rauhul/ece395/flywheel_gearbox/flywheel_gearbox_parts.docx

Note: The Vex Robotics site has multiple parts per page.

Part | Part No. | Unit Price | Quantity | Total Cost | Link
12t CIM Motor Gear with Mounting Hardware (aluminum) | 217-2614 | 6.99 | 2 | 13.98 | http://www.vexrobotics.com/vexpro/motion/vexpro-gears/cim-motor-gears.html
18t Gear with 1/2" Hex Bore | 217-3209 | 6.99 | 1 | 6.99 | http://www.vexrobotics.com/vexpro/motion/vexpro-gears/1-2-hex-bore.html
60t Gear with 1/2" Hex Bore | 217-3574 | 14.99 | 2 | 29.98 | http://www.vexrobotics.com/vexpro/motion/vexpro-gears/1-2-hex-bore.html
Flanged Bearing - 0.500in x 1.125in x 0.313in | 217-2731 | 2.99 | 5 | 14.95 | http://www.vexrobotics.com/vexpro/motion/bearings.html
CIM Motor | 217-2000 | 27.99 | 2 | 55.98 | http://www.vexrobotics.com/vexpro/motors-electronics/217-2000.html
Black-Oxide Alloy Steel Socket Head Screw, 10-32 Thread Size, 1/2" Long | 91251A342 | 9.25 | 1 | 9.25 | https://www.mcmaster.com/#91251a342/

Total Cost: $131.13 (untaxed)
