rauhul/ece395/flywheel_gearbox/gearbox.SLDASM

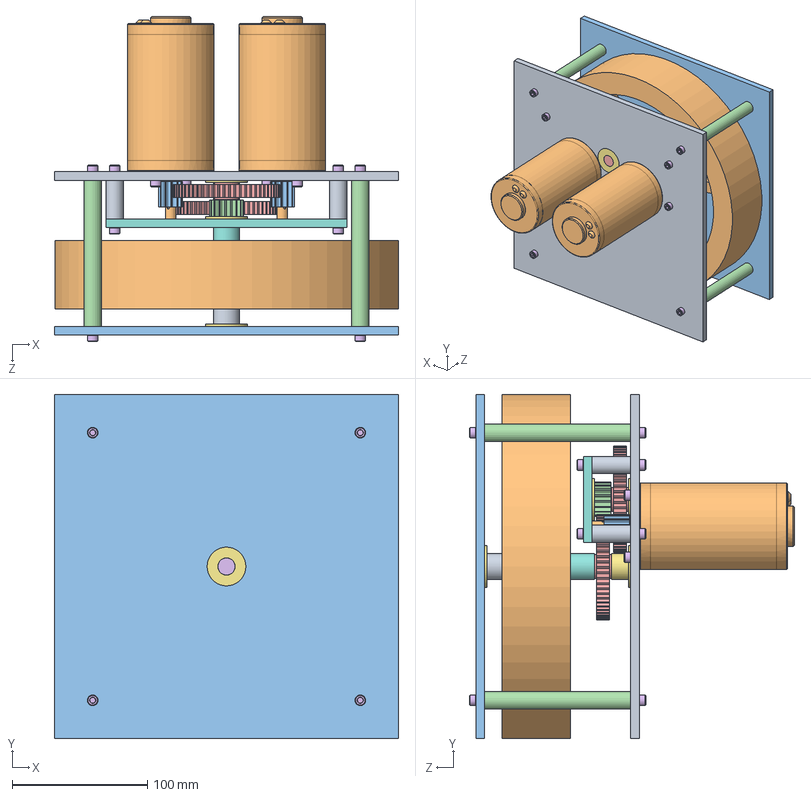
[picture p7: CAD file, 2017-03-07]
flywheel_gearbox/gearbox.SLDASM
254.0 x 254.0 x 240.0 mm
motor_plate
cim_motor x 2
12t_gear x 2
18t_gear
60t_gear x 2
FR8-2RZ x 4
support_plate
support_standoff x 4
flywheel
flywheel_plate
main_standoff x 4
support_shaft
flywheel_shaft
flywheel_shaft_spacer_1
flywheel_shaft_spacer_2
flywheel_shaft_spacer_3
