rauhul/ece395/flywheel_gearbox/main_standoff.SLDPRT

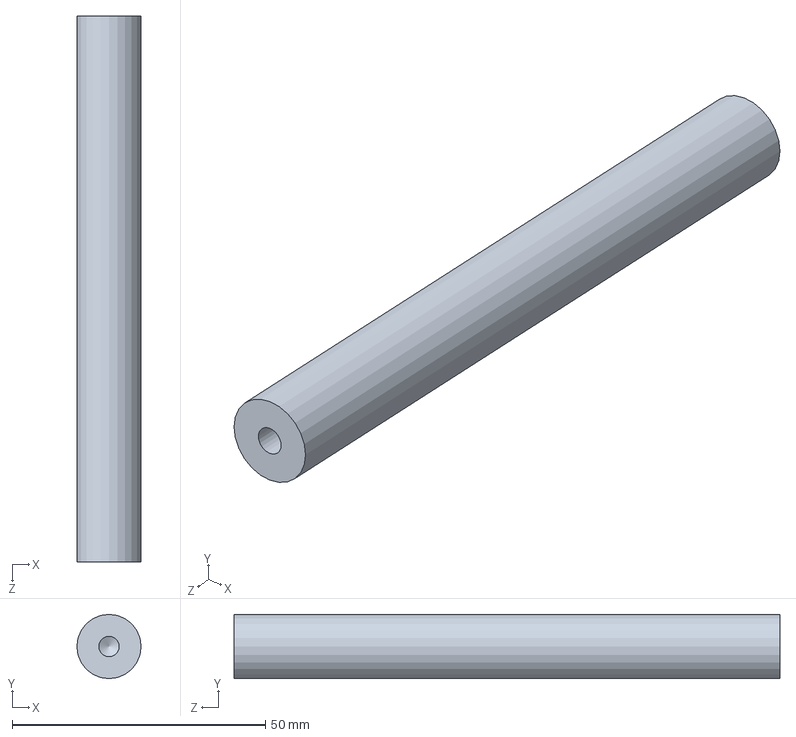
[picture p8: CAD file, 2017-03-07]
flywheel_gearbox/main_standoff.SLDPRT
12.7 x 12.7 x 107.8 mm
