rauhul/ece395/flywheel_gearbox/flywheel_shaft_spacer_1.SLDPRT

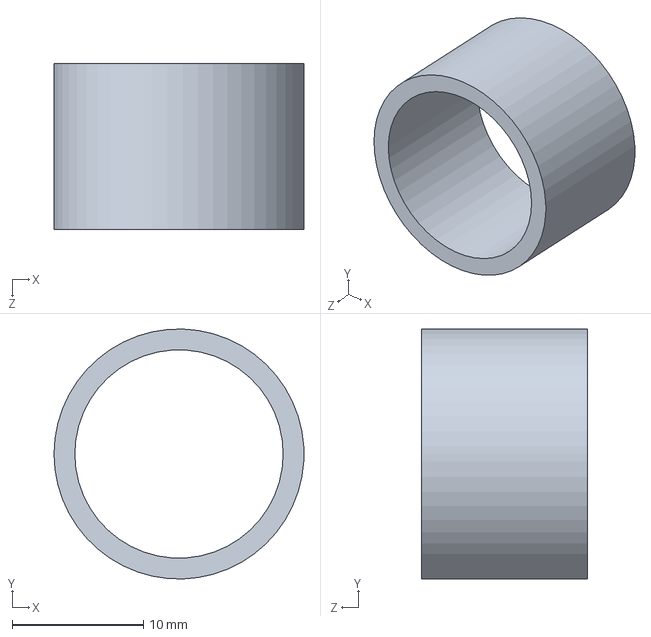
[picture p9: CAD file, 2017-03-07]
flywheel_gearbox/flywheel_shaft_spacer_1.SLDPRT
19.1 x 19.0 x 12.6 mm
