rauhul/ece395/flywheel_gearbox/0.500 10-32.SLDPRT

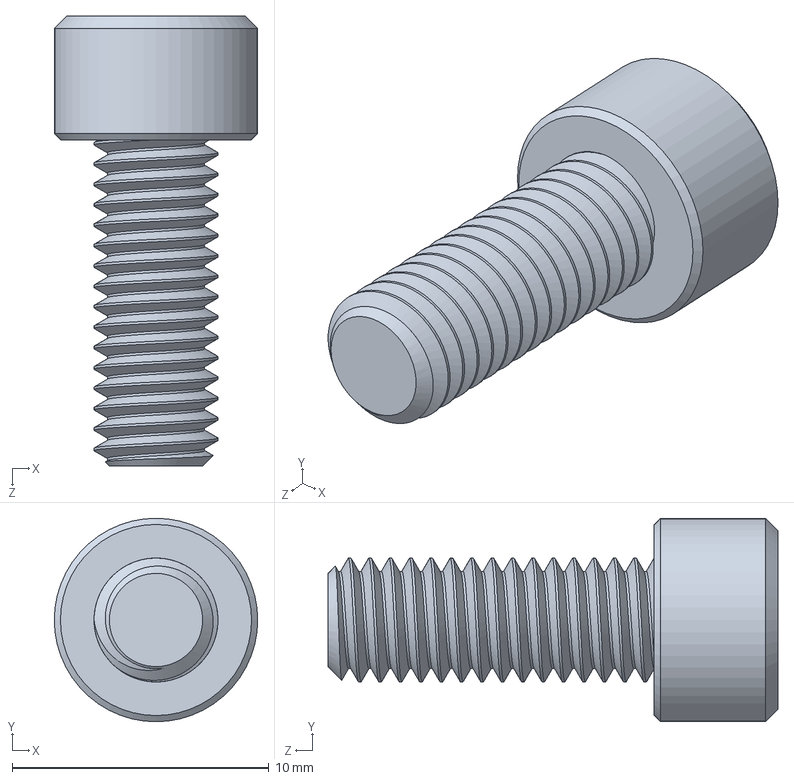
[picture p10: CAD file, 2017-03-07]
flywheel_gearbox/0.500 10-32.SLDPRT
7.92 x 7.92 x 17.5 mm
