rauhul/ece395/flywheel_gearbox/flywheel_shaft_spacer_2.SLDPRT

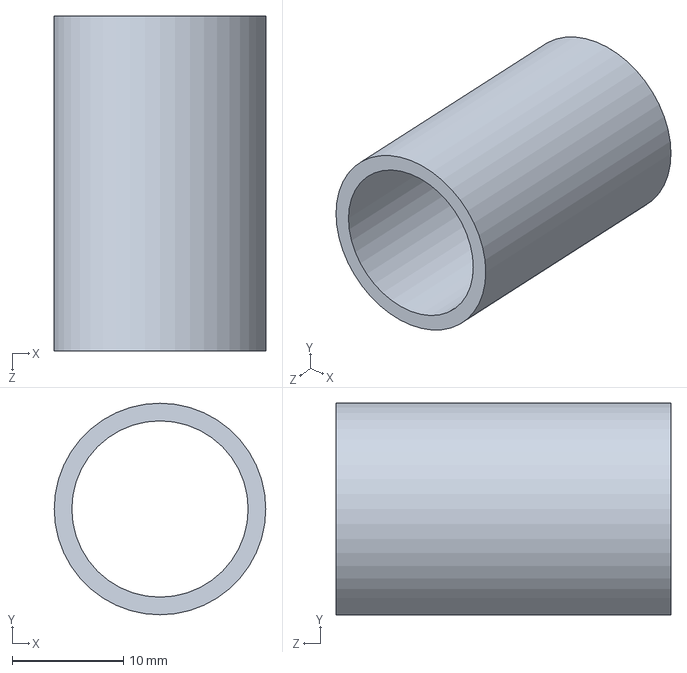
[picture p11: CAD file, 2017-03-07]
flywheel_gearbox/flywheel_shaft_spacer_2.SLDPRT
19.1 x 19.1 x 30.2 mm
