rauhul/ece395/flywheel_gearbox/18t_gear.SLDPRT

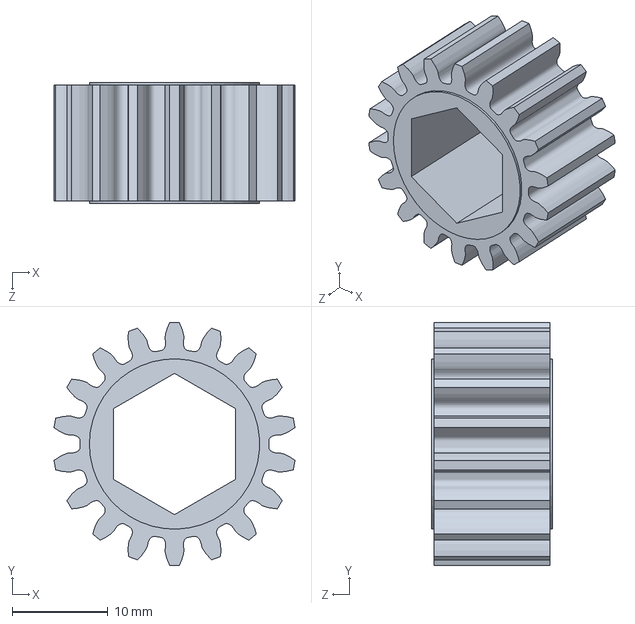
[picture p12: CAD file, 2017-03-07]
flywheel_gearbox/18t_gear.SLDPRT
25.2 x 25.4 x 12.6 mm
