rauhul/ece395/flywheel_gearbox/flywheel_shaft_spacer_3.SLDPRT

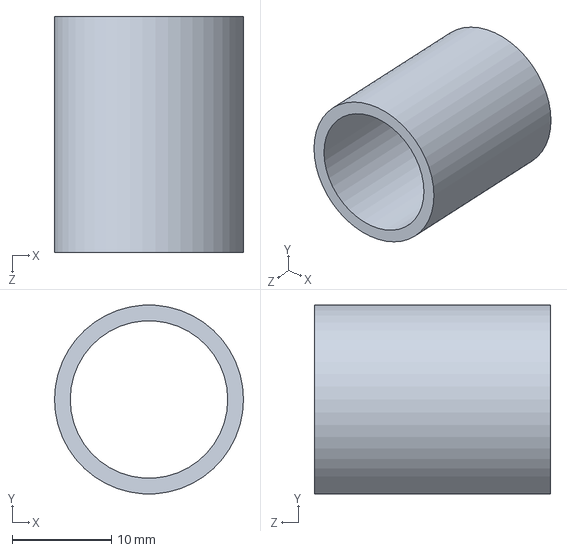
[picture p13: CAD file, 2017-03-07]
flywheel_gearbox/flywheel_shaft_spacer_3.SLDPRT
19.1 x 19.0 x 23.8 mm
