rauhul/ece395/flywheel_gearbox/support_shaft.SLDPRT

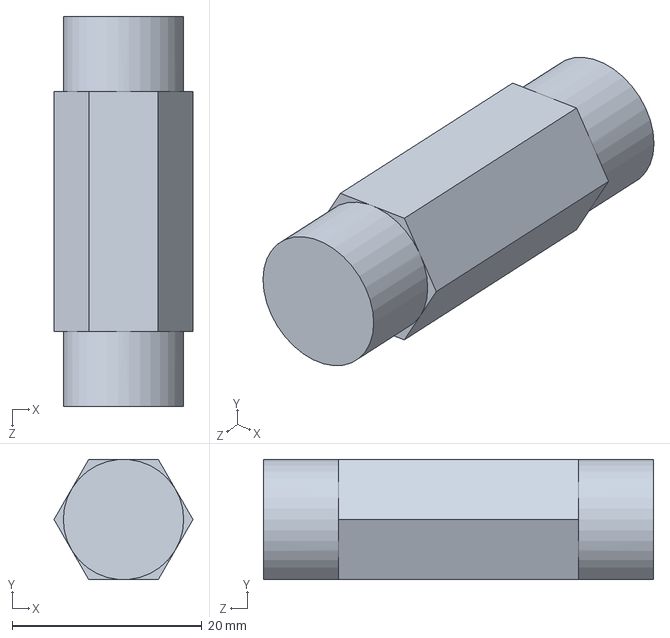
[picture p14: CAD file, 2017-03-07]
flywheel_gearbox/support_shaft.SLDPRT
14.7 x 12.7 x 41.2 mm
