rauhul/ece395/flywheel_gearbox/support_standoff.SLDPRT

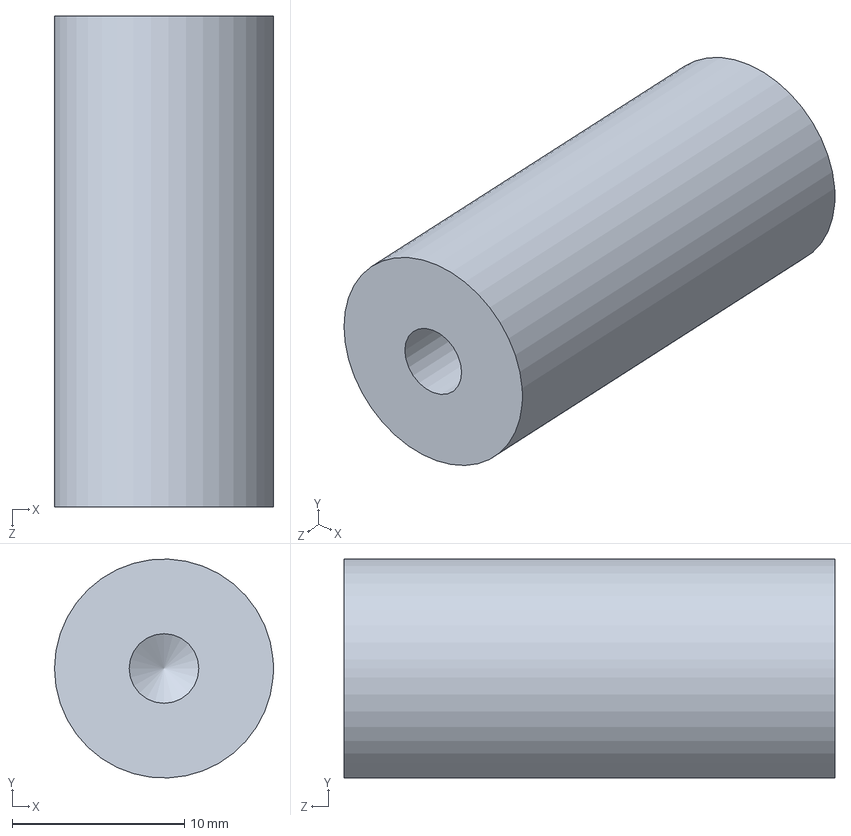
[picture p15: CAD file, 2017-03-07]
flywheel_gearbox/support_standoff.SLDPRT
12.7 x 12.7 x 28.5 mm
