rauhul/ece395/flywheel_gearbox/12t_gear.SLDPRT

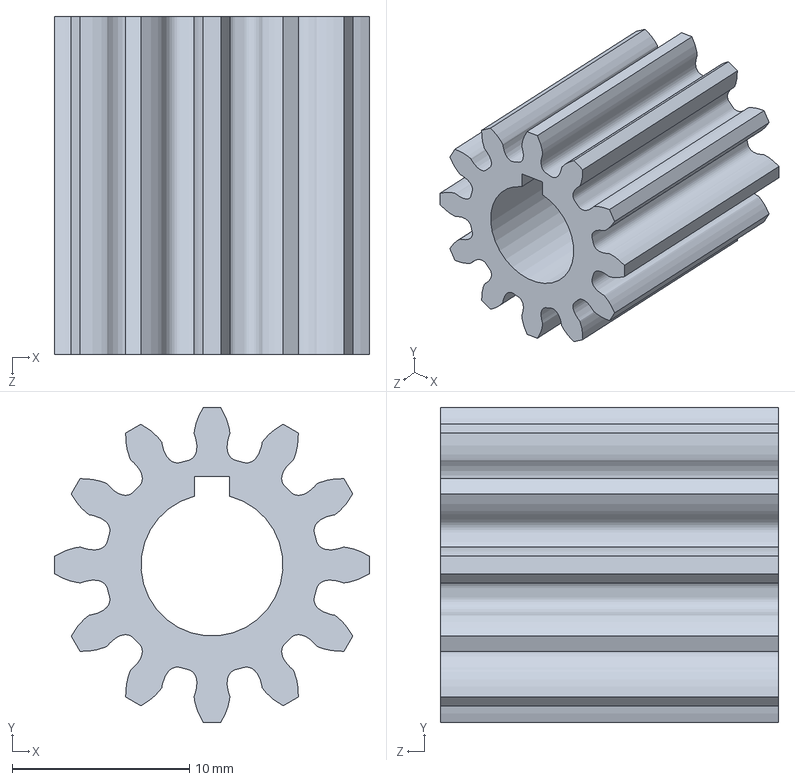
[picture p16: CAD file, 2017-03-07]
flywheel_gearbox/12t_gear.SLDPRT
17.8 x 17.8 x 19.1 mm
