rauhul/ece395/flywheel_gearbox/flywheel.SLDPRT

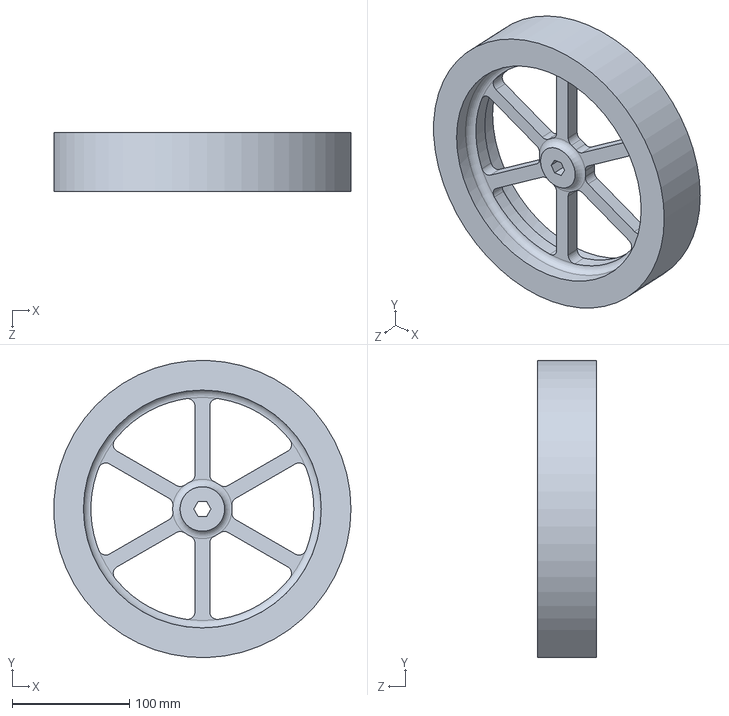
[picture p17: CAD file, 2017-03-07]
flywheel_gearbox/flywheel.SLDPRT
253.8 x 253.9 x 50.8 mm
