rauhul/ece395/flywheel_gearbox/FR8-2RZ.SLDPRT

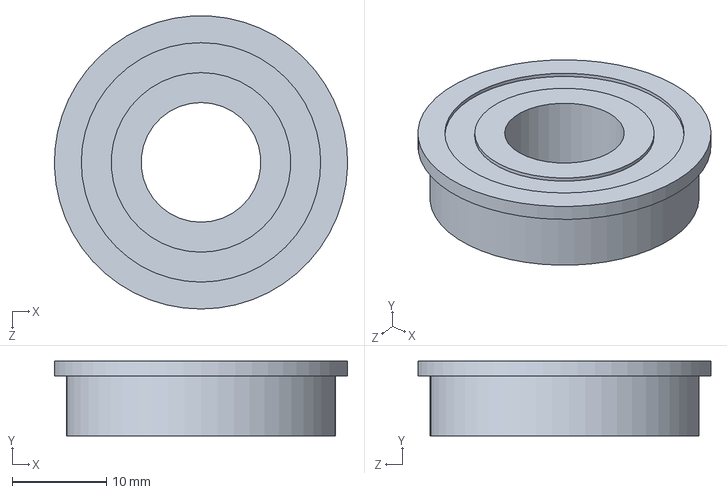
[picture p18: CAD file, 2017-03-07]
flywheel_gearbox/FR8-2RZ.SLDPRT
31.1 x 7.94 x 31.1 mm
