rauhul/ece395/flywheel_gearbox/60t_gear.SLDPRT

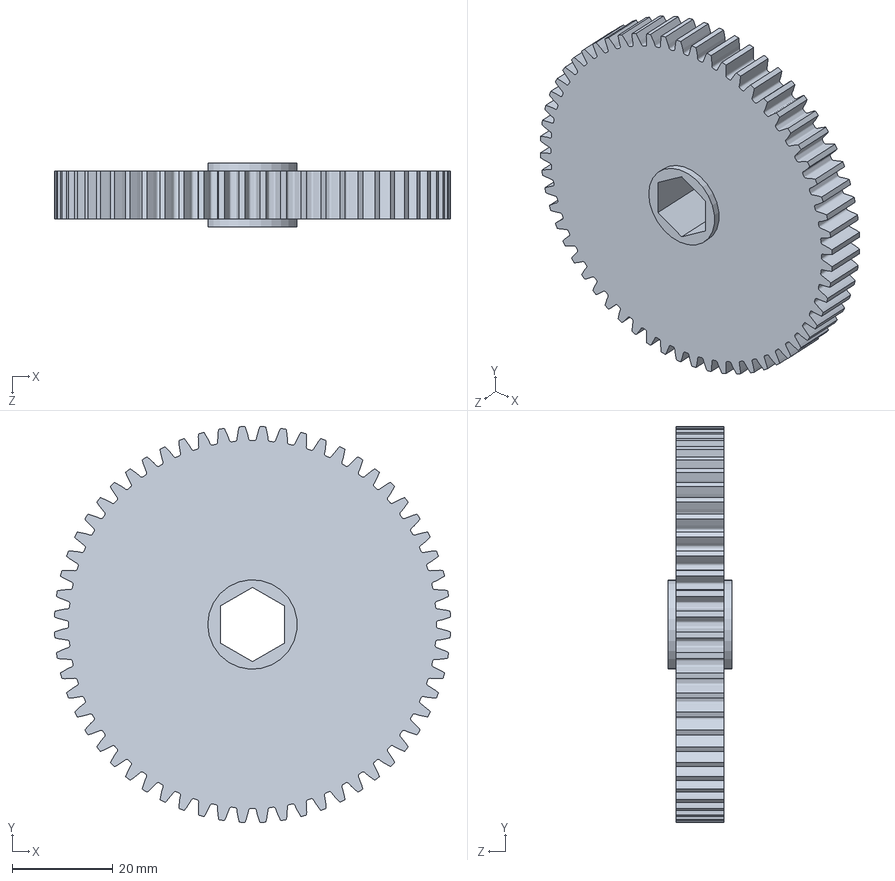
[picture p19: CAD file, 2017-03-07]
flywheel_gearbox/60t_gear.SLDPRT
78.7 x 78.7 x 12.6 mm
