rauhul/ece395/flywheel_gearbox/flywheel_shaft.SLDPRT

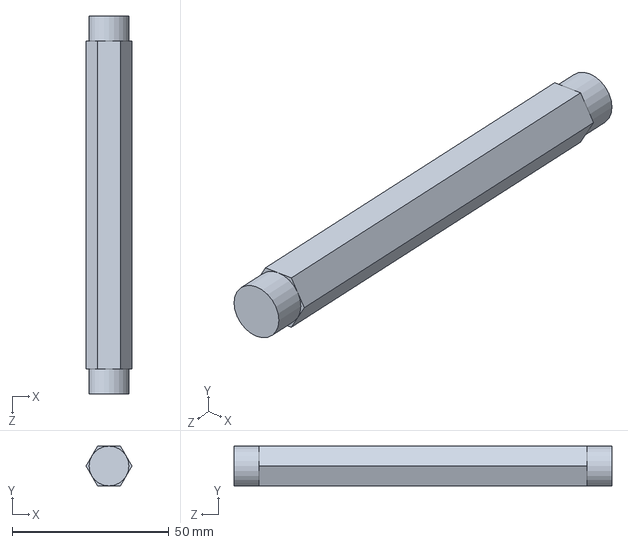
[picture p20: CAD file, 2017-03-07]
flywheel_gearbox/flywheel_shaft.SLDPRT
14.7 x 12.7 x 120.5 mm
