rauhul/ece395/flywheel_gearbox/motor_plate.SLDPRT

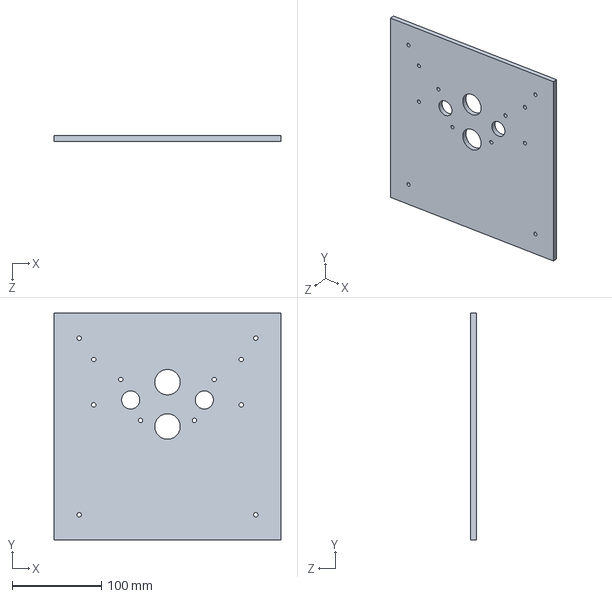
[picture p21: CAD file, 2017-02-09]
flywheel_gearbox/motor_plate.SLDPRT
254.0 x 254.0 x 6.35 mm
