rauhul/ece395/flywheel_gearbox/cim_motor.SLDPRT

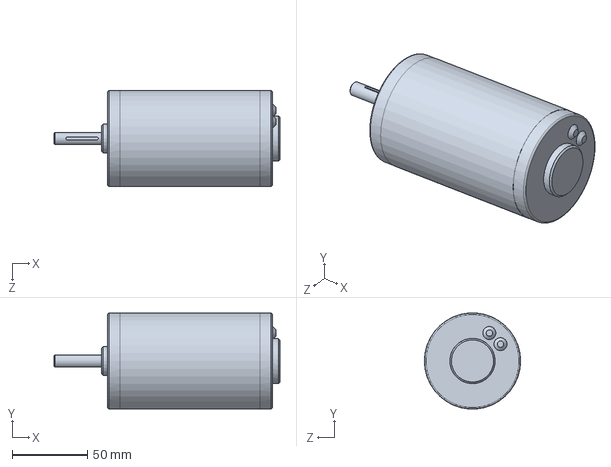
[picture p22: CAD file, 2017-02-09]
flywheel_gearbox/cim_motor.SLDPRT
150.2 x 63.8 x 64.0 mm
