rauhul/ece395/flywheel_gearbox/support_plate.SLDPRT

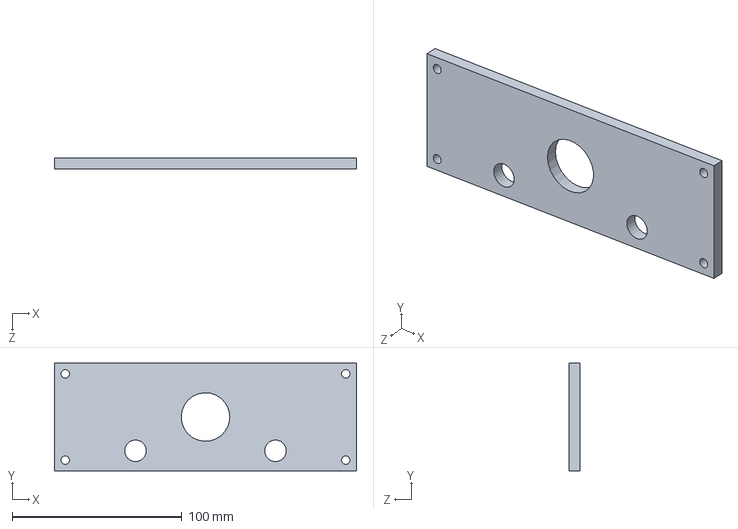
[picture p23: CAD file, 2017-02-09]
flywheel_gearbox/support_plate.SLDPRT
177.8 x 63.5 x 6.35 mm
