rauhul/ece395/(list of files, cad)

Other CAD files:
6050 DMP Code/msp430/eMD-6.0/Debug/core/driver/eMPL/inv_mpu_dmp_motion_driver.obj
6050 DMP Code/msp430/eMD-6.0/Debug/core/driver/msp430/F5xx_F6xx_Core_Lib/HAL_UCS.obj
6050 DMP Code/msp430/eMD-6.0/Debug/core/driver/msp430/msp430_i2c.obj
6050 DMP Code/msp430/eMD-6.0/Debug/core/driver/msp430/USB_API/USB_CDC_API/UsbCdc.obj
6050 DMP Code/msp430/eMD-6.0/Debug/core/driver/msp430/USB_API/USB_Common/usb.obj
6050 DMP Code/msp430/eMD-6.0/Debug/core/driver/msp430/USB_API/USB_HID_API/UsbHid.obj
6050 DMP Code/msp430/eMD-6.0/Debug/core/driver/msp430/USB_API/USB_MSC_API/UsbMscReq.obj
6050 DMP Code/msp430/eMD-6.0/Debug/core/driver/msp430/USB_API/USB_PHDC_API/UsbPHDC.obj
6050 DMP Code/msp430/eMD-6.0/Debug/core/driver/msp430/USB_eMPL/usbEventHandling.obj
6050 DMP Code/msp430/eMD-6.0/Debug/core/eMPL-hal/eMPL_outputs.obj
6050 DMP Code/msp430/eMD-6.0/Debug/core/mllite/data_builder.obj
6050 DMP Code/msp430/eMD-6.0/Debug/simple_apps/msp430/mllite_test.obj
6050 DMP Code/msp430/eMD-6.0/Debug/core/driver/eMPL/inv_mpu.obj
6050 DMP Code/msp430/eMD-6.0/Debug/core/driver/msp430/F5xx_F6xx_Core_Lib/HAL_FLASH.obj
6050 DMP Code/msp430/eMD-6.0/Debug/core/driver/msp430/msp430_interrupt.obj
6050 DMP Code/msp430/eMD-6.0/Debug/core/driver/msp430/USB_API/USB_Common/dma.obj
6050 DMP Code/msp430/eMD-6.0/Debug/core/driver/msp430/USB_API/USB_HID_API/UsbHidReq.obj
6050 DMP Code/msp430/eMD-6.0/Debug/core/driver/msp430/USB_API/USB_MSC_API/UsbMscScsi.obj
6050 DMP Code/msp430/eMD-6.0/Debug/core/driver/msp430/USB_eMPL/usbConstructs.obj
6050 DMP Code/msp430/eMD-6.0/Debug/core/mllite/ml_math_func.obj
6050 DMP Code/msp430/eMD-6.0/Debug/core/driver/msp430/F5xx_F6xx_Core_Lib/HAL_PMM.obj
6050 DMP Code/msp430/eMD-6.0/Debug/core/driver/msp430/msp430_clock.obj
6050 DMP Code/msp430/eMD-6.0/Debug/core/driver/msp430/USB_API/USB_MSC_API/UsbMscStateMachine.obj
6050 DMP Code/msp430/eMD-6.0/Debug/core/driver/msp430/USB_eMPL/UsbIsr.obj
6050 DMP Code/msp430/eMD-6.0/Debug/core/mllite/message_layer.obj
6050 DMP Code/msp430/eMD-6.0/Debug/core/driver/msp430/F5xx_F6xx_Core_Lib/HAL_TLV.obj
6050 DMP Code/msp430/eMD-6.0/Debug/core/driver/msp430/USB_eMPL/log_msp430.obj
6050 DMP Code/msp430/eMD-6.0/Debug/core/mllite/mlmath.obj
6050 DMP Code/msp430/eMD-6.0/Debug/core/driver/msp430/F5xx_F6xx_Core_Lib/HAL_PMAP.obj
6050 DMP Code/msp430/eMD-6.0/Debug/core/driver/msp430/USB_eMPL/descriptors.obj
6050 DMP Code/msp430/eMD-6.0/Debug/core/mllite/hal_outputs.obj
6050 DMP Code/msp430/eMD-6.0/Debug/core/mllite/results_holder.obj
6050 DMP Code/msp430/eMD-6.0/Debug/core/mllite/mpl.obj
6050 DMP Code/msp430/eMD-6.0/Debug/core/mllite/storage_manager.obj
6050 DMP Code/msp430/eMD-6.0/Debug/core/mllite/start_manager.obj
flywheel_gearbox/flywheel_plate.SLDPRT
flywheel_gearbox/drawings/flywheel.SLDDRW
flywheel_gearbox/drawings/flywheel_plate.SLDDRW
flywheel_gearbox/drawings/motor_plate.SLDDRW
flywheel_gearbox/drawings/shafts.SLDDRW
flywheel_gearbox/drawings/spacers.SLDDRW
flywheel_gearbox/drawings/standoffs.SLDDRW
flywheel_gearbox/drawings/support_plate.SLDDRW
