rauhul/ece395/test_proj/Objects/test_proj.htm

# Static Call Graph for image .\Objects\test_proj.axf

#<CALLGRAPH># ARM Linker, 5060183: Last Updated: Tue Apr 18 16:29:37 2017

### Maximum Stack Usage = 192 bytes + Unknown(Functions without stacksize, Cycles, Untraceable Function Pointers)

### Call chain for Maximum Stack Depth:

__rt_entry_main ⇒ main ⇒ setup_MPU_6050 ⇒ mpu_init ⇒ reg_int_cb ⇒ __2printf ⇒ _printf_char_file ⇒ _printf_char_common ⇒ __printf

### Functions with no stack information

- __user_initial_stackheap

### Mutually Recursive functions

- NMI_Handler ⇒ NMI_Handler
- HardFault_Handler ⇒ HardFault_Handler
- SVC_Handler ⇒ SVC_Handler
- PendSV_Handler ⇒ PendSV_Handler
- SysTick_Handler ⇒ SysTick_Handler
- ADC_IRQHandler ⇒ ADC_IRQHandler

### Function Pointers

- ADC_IRQHandler from startup_lpc11xx.o(.text) referenced from startup_lpc11xx.o(RESET)
- BOD_IRQHandler from startup_lpc11xx.o(.text) referenced from startup_lpc11xx.o(RESET)
- CAN_IRQHandler from startup_lpc11xx.o(.text) referenced from startup_lpc11xx.o(RESET)
- FMC_IRQHandler from startup_lpc11xx.o(.text) referenced from startup_lpc11xx.o(RESET)
- HardFault_Handler from startup_lpc11xx.o(.text) referenced from startup_lpc11xx.o(RESET)
- I2C_IRQHandler from i2c.o(i.I2C_IRQHandler) referenced from startup_lpc11xx.o(RESET)
- NMI_Handler from startup_lpc11xx.o(.text) referenced from startup_lpc11xx.o(RESET)
- PIOINT0_IRQHandler from startup_lpc11xx.o(.text) referenced from startup_lpc11xx.o(RESET)
- PIOINT1_IRQHandler from m0_mpu_6050.o(i.PIOINT1_IRQHandler) referenced from startup_lpc11xx.o(RESET)
- PIOINT2_IRQHandler from startup_lpc11xx.o(.text) referenced from startup_lpc11xx.o(RESET)
- PIOINT3_IRQHandler from startup_lpc11xx.o(.text) referenced from startup_lpc11xx.o(RESET)
- PendSV_Handler from startup_lpc11xx.o(.text) referenced from startup_lpc11xx.o(RESET)
- Reset_Handler from startup_lpc11xx.o(.text) referenced from startup_lpc11xx.o(RESET)
- SSP0_IRQHandler from startup_lpc11xx.o(.text) referenced from startup_lpc11xx.o(RESET)
- SSP1_IRQHandler from startup_lpc11xx.o(.text) referenced from startup_lpc11xx.o(RESET)
- SVC_Handler from startup_lpc11xx.o(.text) referenced from startup_lpc11xx.o(RESET)
- SysTick_Handler from startup_lpc11xx.o(.text) referenced from startup_lpc11xx.o(RESET)
- SystemInit from system_lpc11xx.o(i.SystemInit) referenced from startup_lpc11xx.o(.text)
- TIMER16_0_IRQHandler from startup_lpc11xx.o(.text) referenced from startup_lpc11xx.o(RESET)
- TIMER16_1_IRQHandler from startup_lpc11xx.o(.text) referenced from startup_lpc11xx.o(RESET)
- TIMER32_0_IRQHandler from timer32.o(i.TIMER32_0_IRQHandler) referenced from startup_lpc11xx.o(RESET)
- TIMER32_1_IRQHandler from timer32.o(i.TIMER32_1_IRQHandler) referenced from startup_lpc11xx.o(RESET)
- UART_IRQHandler from startup_lpc11xx.o(.text) referenced from startup_lpc11xx.o(RESET)
- USB_FIQHandler from startup_lpc11xx.o(.text) referenced from startup_lpc11xx.o(RESET)
- USB_IRQHandler from startup_lpc11xx.o(.text) referenced from startup_lpc11xx.o(RESET)
- WAKEUP_IRQHandler from startup_lpc11xx.o(.text) referenced 13 times from startup_lpc11xx.o(RESET)
- WDT_IRQHandler from startup_lpc11xx.o(.text) referenced from startup_lpc11xx.o(RESET)
- __main from __main.o(!!!main) referenced from startup_lpc11xx.o(.text)
- _printf_input_char from _printf_char_common.o(.text) referenced from _printf_char_common.o(.text)
- fputc from retarget.o(i.fputc) referenced from _printf_char_file.o(.text)

### Global Symbols

__main (Thumb, 8 bytes, Stack size 0 bytes, __main.o(!!!main))

[Calls]

- >> __rt_entry
- >> __scatterload

__scatterload (Thumb, 0 bytes, Stack size unknown bytes, __scatter.o(!!!scatter))

[Called By]

- >> __main

__scatterload_rt2 (Thumb, 52 bytes, Stack size unknown bytes, __scatter.o(!!!scatter), UNUSED)

[Calls]

- >> __rt_entry

__scatterload_rt2_thumb_only (Thumb, 0 bytes, Stack size unknown bytes, __scatter.o(!!!scatter), UNUSED)

__scatterload_null (Thumb, 0 bytes, Stack size unknown bytes, __scatter.o(!!!scatter), UNUSED)

__scatterload_copy (Thumb, 26 bytes, Stack size unknown bytes, __scatter_copy.o(!!handler_copy), UNUSED)

[Calls]

- >> __scatterload_copy

[Called By]

- >> __scatterload_copy

__scatterload_zeroinit (Thumb, 28 bytes, Stack size unknown bytes, __scatter_zi.o(!!handler_zi), UNUSED)

_printf_percent (Thumb, 0 bytes, Stack size unknown bytes, _printf_percent.o(.ARM.Collect$$_printf_percent$$00000000))

[Called By]

- >> __printf

_printf_d (Thumb, 0 bytes, Stack size unknown bytes, _printf_d.o(.ARM.Collect$$_printf_percent$$00000009))

[Stack]

- Max Depth = 72 + Unknown Stack Size
- Call Chain = _printf_d ⇒ _printf_int_dec ⇒ _printf_int_common

[Calls]

- >> _printf_percent_end
- >> _printf_int_dec

_printf_percent_end (Thumb, 0 bytes, Stack size unknown bytes, _printf_percent_end.o(.ARM.Collect$$_printf_percent$$00000017))

[Called By]

- >> _printf_d

__rt_lib_init (Thumb, 0 bytes, Stack size unknown bytes, libinit.o(.ARM.Collect$$libinit$$00000000))

[Called By]

- >> __rt_entry_li

__rt_lib_init_alloca_1 (Thumb, 0 bytes, Stack size unknown bytes, libinit2.o(.ARM.Collect$$libinit$$0000002E))

__rt_lib_init_argv_1 (Thumb, 0 bytes, Stack size unknown bytes, libinit2.o(.ARM.Collect$$libinit$$0000002C))

__rt_lib_init_atexit_1 (Thumb, 0 bytes, Stack size unknown bytes, libinit2.o(.ARM.Collect$$libinit$$0000001B))

__rt_lib_init_clock_1 (Thumb, 0 bytes, Stack size unknown bytes, libinit2.o(.ARM.Collect$$libinit$$00000021))

__rt_lib_init_cpp_1 (Thumb, 0 bytes, Stack size unknown bytes, libinit2.o(.ARM.Collect$$libinit$$00000032))

__rt_lib_init_exceptions_1 (Thumb, 0 bytes, Stack size unknown bytes, libinit2.o(.ARM.Collect$$libinit$$00000030))

__rt_lib_init_fp_1 (Thumb, 0 bytes, Stack size unknown bytes, libinit2.o(.ARM.Collect$$libinit$$00000002))

__rt_lib_init_fp_trap_1 (Thumb, 0 bytes, Stack size unknown bytes, libinit2.o(.ARM.Collect$$libinit$$0000001F))

__rt_lib_init_getenv_1 (Thumb, 0 bytes, Stack size unknown bytes, libinit2.o(.ARM.Collect$$libinit$$00000023))

__rt_lib_init_heap_1 (Thumb, 0 bytes, Stack size unknown bytes, libinit2.o(.ARM.Collect$$libinit$$0000000A))

__rt_lib_init_lc_collate_1 (Thumb, 0 bytes, Stack size unknown bytes, libinit2.o(.ARM.Collect$$libinit$$00000011))

__rt_lib_init_lc_ctype_1 (Thumb, 0 bytes, Stack size unknown bytes, libinit2.o(.ARM.Collect$$libinit$$00000013))

__rt_lib_init_lc_monetary_1 (Thumb, 0 bytes, Stack size unknown bytes, libinit2.o(.ARM.Collect$$libinit$$00000015))

__rt_lib_init_lc_numeric_1 (Thumb, 0 bytes, Stack size unknown bytes, libinit2.o(.ARM.Collect$$libinit$$00000017))

__rt_lib_init_lc_time_1 (Thumb, 0 bytes, Stack size unknown bytes, libinit2.o(.ARM.Collect$$libinit$$00000019))

__rt_lib_init_preinit_1 (Thumb, 0 bytes, Stack size unknown bytes, libinit2.o(.ARM.Collect$$libinit$$00000004))

__rt_lib_init_rand_1 (Thumb, 0 bytes, Stack size unknown bytes, libinit2.o(.ARM.Collect$$libinit$$0000000E))

__rt_lib_init_return (Thumb, 0 bytes, Stack size unknown bytes, libinit2.o(.ARM.Collect$$libinit$$00000033))

__rt_lib_init_signal_1 (Thumb, 0 bytes, Stack size unknown bytes, libinit2.o(.ARM.Collect$$libinit$$0000001D))

__rt_lib_init_stdio_1 (Thumb, 0 bytes, Stack size unknown bytes, libinit2.o(.ARM.Collect$$libinit$$00000025))

__rt_lib_init_user_alloc_1 (Thumb, 0 bytes, Stack size unknown bytes, libinit2.o(.ARM.Collect$$libinit$$0000000C))

__rt_lib_shutdown (Thumb, 0 bytes, Stack size unknown bytes, libshutdown.o(.ARM.Collect$$libshutdown$$00000000))

[Called By]

- >> __rt_exit_ls

__rt_lib_shutdown_cpp_1 (Thumb, 0 bytes, Stack size unknown bytes, libshutdown2.o(.ARM.Collect$$libshutdown$$00000002))

__rt_lib_shutdown_fp_trap_1 (Thumb, 0 bytes, Stack size unknown bytes, libshutdown2.o(.ARM.Collect$$libshutdown$$00000007))

__rt_lib_shutdown_heap_1 (Thumb, 0 bytes, Stack size unknown bytes, libshutdown2.o(.ARM.Collect$$libshutdown$$0000000F))

__rt_lib_shutdown_return (Thumb, 0 bytes, Stack size unknown bytes, libshutdown2.o(.ARM.Collect$$libshutdown$$00000010))

__rt_lib_shutdown_signal_1 (Thumb, 0 bytes, Stack size unknown bytes, libshutdown2.o(.ARM.Collect$$libshutdown$$0000000A))

__rt_lib_shutdown_stdio_1 (Thumb, 0 bytes, Stack size unknown bytes, libshutdown2.o(.ARM.Collect$$libshutdown$$00000004))

__rt_lib_shutdown_user_alloc_1 (Thumb, 0 bytes, Stack size unknown bytes, libshutdown2.o(.ARM.Collect$$libshutdown$$0000000C))

__rt_entry (Thumb, 0 bytes, Stack size unknown bytes, __rtentry.o(.ARM.Collect$$rtentry$$00000000))

[Called By]

- >> __main
- >> __scatterload_rt2

__rt_entry_presh_1 (Thumb, 0 bytes, Stack size unknown bytes, __rtentry2.o(.ARM.Collect$$rtentry$$00000002))

__rt_entry_sh (Thumb, 0 bytes, Stack size unknown bytes, __rtentry4.o(.ARM.Collect$$rtentry$$00000004))

[Stack]

- Max Depth = 8 + Unknown Stack Size
- Call Chain = __rt_entry_sh ⇒ __user_setup_stackheap

[Calls]

- >> __user_setup_stackheap

__rt_entry_li (Thumb, 0 bytes, Stack size unknown bytes, __rtentry2.o(.ARM.Collect$$rtentry$$0000000A))

[Calls]

- >> __rt_lib_init

__rt_entry_postsh_1 (Thumb, 0 bytes, Stack size unknown bytes, __rtentry2.o(.ARM.Collect$$rtentry$$00000009))

__rt_entry_main (Thumb, 0 bytes, Stack size unknown bytes, __rtentry2.o(.ARM.Collect$$rtentry$$0000000D))

[Stack]

- Max Depth = 192 + Unknown Stack Size
- Call Chain = __rt_entry_main ⇒ main ⇒ setup_MPU_6050 ⇒ mpu_init ⇒ reg_int_cb ⇒ __2printf ⇒ _printf_char_file ⇒ _printf_char_common ⇒ __printf

[Calls]

- >> main
- >> exit

__rt_entry_postli_1 (Thumb, 0 bytes, Stack size unknown bytes, __rtentry2.o(.ARM.Collect$$rtentry$$0000000C))

__rt_exit (Thumb, 0 bytes, Stack size unknown bytes, rtexit.o(.ARM.Collect$$rtexit$$00000000))

[Called By]

- >> exit

__rt_exit_ls (Thumb, 0 bytes, Stack size unknown bytes, rtexit2.o(.ARM.Collect$$rtexit$$00000003))

[Calls]

- >> __rt_lib_shutdown

__rt_exit_prels_1 (Thumb, 0 bytes, Stack size unknown bytes, rtexit2.o(.ARM.Collect$$rtexit$$00000002))

__rt_exit_exit (Thumb, 0 bytes, Stack size unknown bytes, rtexit2.o(.ARM.Collect$$rtexit$$00000004))

[Calls]

- >> _sys_exit

Reset_Handler (Thumb, 8 bytes, Stack size 0 bytes, startup_lpc11xx.o(.text))
[Address Reference Count : 1]

- startup_lpc11xx.o(RESET)

NMI_Handler (Thumb, 2 bytes, Stack size 0 bytes, startup_lpc11xx.o(.text))

[Calls]

- >> NMI_Handler

[Called By]

- >> NMI_Handler

[Address Reference Count : 1]

- startup_lpc11xx.o(RESET)

HardFault_Handler (Thumb, 2 bytes, Stack size 0 bytes, startup_lpc11xx.o(.text))

[Calls]

- >> HardFault_Handler

[Called By]

- >> HardFault_Handler

[Address Reference Count : 1]

- startup_lpc11xx.o(RESET)

SVC_Handler (Thumb, 2 bytes, Stack size 0 bytes, startup_lpc11xx.o(.text))

[Calls]

- >> SVC_Handler

[Called By]

- >> SVC_Handler

[Address Reference Count : 1]

- startup_lpc11xx.o(RESET)

PendSV_Handler (Thumb, 2 bytes, Stack size 0 bytes, startup_lpc11xx.o(.text))

[Calls]

- >> PendSV_Handler

[Called By]

- >> PendSV_Handler

[Address Reference Count : 1]

- startup_lpc11xx.o(RESET)

SysTick_Handler (Thumb, 2 bytes, Stack size 0 bytes, startup_lpc11xx.o(.text))

[Calls]

- >> SysTick_Handler

[Called By]

- >> SysTick_Handler

[Address Reference Count : 1]

- startup_lpc11xx.o(RESET)

ADC_IRQHandler (Thumb, 0 bytes, Stack size 0 bytes, startup_lpc11xx.o(.text))

[Calls]

- >> ADC_IRQHandler

[Called By]

- >> ADC_IRQHandler

[Address Reference Count : 1]

- startup_lpc11xx.o(RESET)

BOD_IRQHandler (Thumb, 0 bytes, Stack size 0 bytes, startup_lpc11xx.o(.text))
[Address Reference Count : 1]

- startup_lpc11xx.o(RESET)

CAN_IRQHandler (Thumb, 0 bytes, Stack size 0 bytes, startup_lpc11xx.o(.text))
[Address Reference Count : 1]

- startup_lpc11xx.o(RESET)

FMC_IRQHandler (Thumb, 0 bytes, Stack size 0 bytes, startup_lpc11xx.o(.text))
[Address Reference Count : 1]

- startup_lpc11xx.o(RESET)

PIOINT0_IRQHandler (Thumb, 0 bytes, Stack size 0 bytes, startup_lpc11xx.o(.text))
[Address Reference Count : 1]

- startup_lpc11xx.o(RESET)

PIOINT2_IRQHandler (Thumb, 0 bytes, Stack size 0 bytes, startup_lpc11xx.o(.text))
[Address Reference Count : 1]

- startup_lpc11xx.o(RESET)

PIOINT3_IRQHandler (Thumb, 0 bytes, Stack size 0 bytes, startup_lpc11xx.o(.text))
[Address Reference Count : 1]

- startup_lpc11xx.o(RESET)

SSP0_IRQHandler (Thumb, 0 bytes, Stack size 0 bytes, startup_lpc11xx.o(.text))
[Address Reference Count : 1]

- startup_lpc11xx.o(RESET)

SSP1_IRQHandler (Thumb, 0 bytes, Stack size 0 bytes, startup_lpc11xx.o(.text))
[Address Reference Count : 1]

- startup_lpc11xx.o(RESET)

TIMER16_0_IRQHandler (Thumb, 0 bytes, Stack size 0 bytes, startup_lpc11xx.o(.text))
[Address Reference Count : 1]

- startup_lpc11xx.o(RESET)

TIMER16_1_IRQHandler (Thumb, 0 bytes, Stack size 0 bytes, startup_lpc11xx.o(.text))
[Address Reference Count : 1]

- startup_lpc11xx.o(RESET)

UART_IRQHandler (Thumb, 0 bytes, Stack size 0 bytes, startup_lpc11xx.o(.text))
[Address Reference Count : 1]

- startup_lpc11xx.o(RESET)

USB_FIQHandler (Thumb, 0 bytes, Stack size 0 bytes, startup_lpc11xx.o(.text))
[Address Reference Count : 1]

- startup_lpc11xx.o(RESET)

USB_IRQHandler (Thumb, 0 bytes, Stack size 0 bytes, startup_lpc11xx.o(.text))
[Address Reference Count : 1]

- startup_lpc11xx.o(RESET)

WAKEUP_IRQHandler (Thumb, 0 bytes, Stack size 0 bytes, startup_lpc11xx.o(.text))
[Address Reference Count : 1]

- startup_lpc11xx.o(RESET)

WDT_IRQHandler (Thumb, 0 bytes, Stack size 0 bytes, startup_lpc11xx.o(.text))
[Address Reference Count : 1]

- startup_lpc11xx.o(RESET)

__user_initial_stackheap (Thumb, 0 bytes, Stack size unknown bytes, startup_lpc11xx.o(.text))

[Called By]

- >> __user_setup_stackheap

__I$use$semihosting (Thumb, 0 bytes, Stack size 0 bytes, use_no_semi.o(.text), UNUSED)

__use_no_semihosting_swi (Thumb, 2 bytes, Stack size 0 bytes, use_no_semi.o(.text), UNUSED)

__2printf (Thumb, 22 bytes, Stack size 24 bytes, noretval__2printf.o(.text))

[Stack]

- Max Depth = 136 + Unknown Stack Size
- Call Chain = __2printf ⇒ _printf_char_file ⇒ _printf_char_common ⇒ __printf

[Calls]

- >> _printf_char_file

[Called By]

- >> reg_int_cb
- >> setup_MPU_6050
- >> main

_printf_int_dec (Thumb, 90 bytes, Stack size 32 bytes, _printf_dec.o(.text))

[Stack]

- Max Depth = 72
- Call Chain = _printf_int_dec ⇒ _printf_int_common

[Calls]

- >> __rt_udiv10
- >> _printf_int_common
- >> _printf_truncate_unsigned (Weak Reference)
- >> _printf_truncate_signed (Weak Reference)

[Called By]

- >> _printf_d

memcmp (Thumb, 90 bytes, Stack size 8 bytes, memcmp.o(.text))

[Stack]

- Max Depth = 8
- Call Chain = memcmp

[Called By]

- >> mpu_load_firmware

__aeabi_memset (Thumb, 18 bytes, Stack size 8 bytes, aeabi_memset.o(.text))

[Stack]

- Max Depth = 8
- Call Chain = __aeabi_memset

[Calls]

- >> _memset

[Called By]

- >> dmp_enable_lp_quat
- >> dmp_enable_6x_lp_quat

_memset_w (Thumb, 26 bytes, Stack size 0 bytes, rt_memclr.o(.text))

[Called By]

- >> __rt_memclr_w
- >> _memset

_memset (Thumb, 30 bytes, Stack size 0 bytes, rt_memclr.o(.text))

[Calls]

- >> _memset_w

[Called By]

- >> __aeabi_memclr
- >> __aeabi_memset

__aeabi_memclr (Thumb, 4 bytes, Stack size 0 bytes, rt_memclr.o(.text))

[Calls]

- >> _memset

[Called By]

- >> mpu_init

__rt_memclr (Thumb, 0 bytes, Stack size 0 bytes, rt_memclr.o(.text), UNUSED)

__aeabi_memclr4 (Thumb, 0 bytes, Stack size 0 bytes, rt_memclr.o(.text), UNUSED)

__aeabi_memclr8 (Thumb, 0 bytes, Stack size 0 bytes, rt_memclr.o(.text), UNUSED)

__rt_memclr_w (Thumb, 4 bytes, Stack size 0 bytes, rt_memclr.o(.text), UNUSED)

[Calls]

- >> _memset_w

__use_two_region_memory (Thumb, 2 bytes, Stack size 0 bytes, heapauxi.o(.text), UNUSED)

__rt_heap_escrow$2region (Thumb, 2 bytes, Stack size 0 bytes, heapauxi.o(.text), UNUSED)

__rt_heap_expand$2region (Thumb, 2 bytes, Stack size 0 bytes, heapauxi.o(.text), UNUSED)

exit (Thumb, 16 bytes, Stack size 8 bytes, exit.o(.text))

[Stack]

- Max Depth = 8 + Unknown Stack Size
- Call Chain = exit

[Calls]

- >> __rt_exit
- >> _call_atexit_fns (Weak Reference)

[Called By]

- >> __rt_entry_main

_sys_exit (Thumb, 4 bytes, Stack size 0 bytes, retarget.o(i._sys_exit))

[Called By]

- >> __rt_exit_exit

__printf (Thumb, 386 bytes, Stack size 32 bytes, __printf_flags_ss_wp.o(.text))

[Stack]

- Max Depth = 32 + Unknown Stack Size
- Call Chain = __printf

[Calls]

- >> _printf_percent
- >> _is_digit

[Called By]

- >> _printf_char_common

__aeabi_uidiv (Thumb, 0 bytes, Stack size 0 bytes, aeabi_sdiv.o(.text), UNUSED)

__aeabi_uidivmod (Thumb, 20 bytes, Stack size 0 bytes, aeabi_sdiv.o(.text))

[Called By]

- >> main

__aeabi_idiv (Thumb, 0 bytes, Stack size 8 bytes, aeabi_sdiv.o(.text), UNUSED)

__aeabi_idivmod (Thumb, 326 bytes, Stack size 8 bytes, aeabi_sdiv.o(.text))

[Stack]

- Max Depth = 8
- Call Chain = __aeabi_idivmod

[Called By]

- >> dmp_set_tap_time_multi
- >> dmp_set_tap_time
- >> dmp_set_shake_reject_timeout
- >> dmp_set_shake_reject_time
- >> dmp_set_shake_reject_thresh
- >> mpu_read_fifo_stream
- >> mpu_set_sample_rate
- >> dmp_set_fifo_rate

__aeabi_fdiv (Thumb, 0 bytes, Stack size 20 bytes, fdiv.o(.text))

[Stack]

- Max Depth = 20
- Call Chain = __aeabi_fdiv

[Called By]

- >> dmp_set_tap_thresh

_fdiv (Thumb, 334 bytes, Stack size 20 bytes, fdiv.o(.text), UNUSED)

[Called By]

- >> _frdiv

_frdiv (Thumb, 8 bytes, Stack size 0 bytes, fdiv.o(.text), UNUSED)

[Calls]

- >> _fdiv

__aeabi_f2uiz (Thumb, 0 bytes, Stack size 0 bytes, ffixui.o(.text))

[Called By]

- >> dmp_set_tap_thresh

_ffixu (Thumb, 48 bytes, Stack size 0 bytes, ffixui.o(.text), UNUSED)

__aeabi_i2f_normalise (Thumb, 72 bytes, Stack size 0 bytes, fflti.o(.text))

[Called By]

- >> __aeabi_ui2f
- >> __aeabi_i2f

__aeabi_i2f (Thumb, 16 bytes, Stack size 0 bytes, fflti.o(.text), UNUSED)

[Calls]

- >> __aeabi_i2f_normalise

_fflt (Thumb, 0 bytes, Stack size 0 bytes, fflti.o(.text), UNUSED)

__aeabi_ui2f (Thumb, 6 bytes, Stack size 0 bytes, fflti.o(.text))

[Calls]

- >> __aeabi_i2f_normalise

[Called By]

- >> dmp_set_tap_thresh

_ffltu (Thumb, 0 bytes, Stack size 0 bytes, fflti.o(.text), UNUSED)

_printf_int_common (Thumb, 176 bytes, Stack size 40 bytes, _printf_intcommon.o(.text))

[Stack]

- Max Depth = 40
- Call Chain = _printf_int_common

[Called By]

- >> _printf_int_dec

_printf_char_file (Thumb, 34 bytes, Stack size 16 bytes, _printf_char_file.o(.text))

[Stack]

- Max Depth = 112 + Unknown Stack Size
- Call Chain = _printf_char_file ⇒ _printf_char_common ⇒ __printf

[Calls]

- >> _printf_char_common
- >> ferror

[Called By]

- >> __2printf

__rt_udiv10 (Thumb, 40 bytes, Stack size 0 bytes, rtudiv10.o(.text))

[Called By]

- >> _printf_int_dec

_printf_char_common (Thumb, 32 bytes, Stack size 64 bytes, _printf_char_common.o(.text))

[Stack]

- Max Depth = 96 + Unknown Stack Size
- Call Chain = _printf_char_common ⇒ __printf

[Calls]

- >> __printf

[Called By]

- >> _printf_char_file

__user_setup_stackheap (Thumb, 62 bytes, Stack size 8 bytes, sys_stackheap_outer.o(.text))

[Stack]

- Max Depth = 8 + Unknown Stack Size
- Call Chain = __user_setup_stackheap

[Calls]

- >> __user_initial_stackheap
- >> __user_perproc_libspace

[Called By]

- >> __rt_entry_sh

__user_libspace (Thumb, 8 bytes, Stack size 0 bytes, libspace.o(.text), UNUSED)

__user_perproc_libspace (Thumb, 0 bytes, Stack size 0 bytes, libspace.o(.text))

[Called By]

- >> __user_setup_stackheap

__user_perthread_libspace (Thumb, 0 bytes, Stack size 0 bytes, libspace.o(.text), UNUSED)

I2CEngine (Thumb, 74 bytes, Stack size 0 bytes, i2c.o(i.I2CEngine))

[Called By]

- >> i2c_write
- >> i2c_read

I2CInit (Thumb, 118 bytes, Stack size 0 bytes, i2c.o(i.I2CInit))

[Called By]

- >> main

I2C_IRQHandler (Thumb, 428 bytes, Stack size 8 bytes, i2c.o(i.I2C_IRQHandler))

[Stack]

- Max Depth = 16
- Call Chain = I2C_IRQHandler ⇒ __ARM_common_switch8

[Calls]

- >> __ARM_common_switch8

[Address Reference Count : 1]

- startup_lpc11xx.o(RESET)

PIOINT1_IRQHandler (Thumb, 36 bytes, Stack size 0 bytes, m0_mpu_6050.o(i.PIOINT1_IRQHandler))
[Address Reference Count : 1]

- startup_lpc11xx.o(RESET)

SER_init (Thumb, 62 bytes, Stack size 0 bytes, serial.o(i.SER_init))

[Called By]

- >> main

SystemInit (Thumb, 108 bytes, Stack size 0 bytes, system_lpc11xx.o(i.SystemInit))
[Address Reference Count : 1]

- startup_lpc11xx.o(.text)

TIMER32_0_IRQHandler (Thumb, 58 bytes, Stack size 0 bytes, timer32.o(i.TIMER32_0_IRQHandler))
[Address Reference Count : 1]

- startup_lpc11xx.o(RESET)

TIMER32_1_IRQHandler (Thumb, 58 bytes, Stack size 0 bytes, timer32.o(i.TIMER32_1_IRQHandler))
[Address Reference Count : 1]

- startup_lpc11xx.o(RESET)

__ARM_common_switch8 (Thumb, 28 bytes, Stack size 8 bytes, system_lpc11xx.o(i.__ARM_common_switch8))

[Stack]

- Max Depth = 8
- Call Chain = __ARM_common_switch8

[Called By]

- >> I2C_IRQHandler

_is_digit (Thumb, 14 bytes, Stack size 0 bytes, __printf_wp.o(i._is_digit))

[Called By]

- >> __printf

delay32Ms (Thumb, 76 bytes, Stack size 12 bytes, timer32.o(i.delay32Ms))

[Stack]

- Max Depth = 20
- Call Chain = delay32Ms ⇒ init_timer32

[Calls]

- >> init_timer32
- >> reset_timer32

[Called By]

- >> delay_ms
- >> main

delay_ms (Thumb, 14 bytes, Stack size 8 bytes, m0_mpu_6050.o(i.delay_ms))

[Stack]

- Max Depth = 28
- Call Chain = delay_ms ⇒ delay32Ms ⇒ init_timer32

[Calls]

- >> delay32Ms

[Called By]

- >> mpu_set_bypass
- >> mpu_reset_fifo
- >> mpu_set_sensors
- >> mpu_init

dmp_enable_6x_lp_quat (Thumb, 54 bytes, Stack size 16 bytes, inv_mpu_dmp_motion_driver.o(i.dmp_enable_6x_lp_quat))

[Stack]

- Max Depth = 80
- Call Chain = dmp_enable_6x_lp_quat ⇒ mpu_write_mem ⇒ i2c_write

[Calls]

- >> mpu_write_mem
- >> mpu_reset_fifo
- >> __aeabi_memset

[Called By]

- >> dmp_enable_feature

dmp_enable_feature (Thumb, 524 bytes, Stack size 24 bytes, inv_mpu_dmp_motion_driver.o(i.dmp_enable_feature))

[Stack]

- Max Depth = 128
- Call Chain = dmp_enable_feature ⇒ dmp_set_tap_thresh ⇒ mpu_write_mem ⇒ i2c_write

[Calls]

- >> dmp_set_tap_time_multi
- >> dmp_set_tap_time
- >> dmp_set_tap_thresh
- >> dmp_set_tap_count
- >> dmp_set_tap_axes
- >> dmp_set_shake_reject_timeout
- >> dmp_set_shake_reject_time
- >> dmp_set_shake_reject_thresh
- >> dmp_enable_lp_quat
- >> dmp_enable_gyro_cal
- >> dmp_enable_6x_lp_quat
- >> mpu_write_mem
- >> mpu_reset_fifo

[Called By]

- >> setup_MPU_6050

dmp_enable_gyro_cal (Thumb, 64 bytes, Stack size 24 bytes, inv_mpu_dmp_motion_driver.o(i.dmp_enable_gyro_cal))

[Stack]

- Max Depth = 88
- Call Chain = dmp_enable_gyro_cal ⇒ mpu_write_mem ⇒ i2c_write

[Calls]

- >> mpu_write_mem

[Called By]

- >> dmp_enable_feature

dmp_enable_lp_quat (Thumb, 54 bytes, Stack size 16 bytes, inv_mpu_dmp_motion_driver.o(i.dmp_enable_lp_quat))

[Stack]

- Max Depth = 80
- Call Chain = dmp_enable_lp_quat ⇒ mpu_write_mem ⇒ i2c_write

[Calls]

- >> mpu_write_mem
- >> mpu_reset_fifo
- >> __aeabi_memset

[Called By]

- >> dmp_enable_feature

dmp_load_motion_driver_firmware (Thumb, 18 bytes, Stack size 8 bytes, inv_mpu_dmp_motion_driver.o(i.dmp_load_motion_driver_firmware))

[Stack]

- Max Depth = 136
- Call Chain = dmp_load_motion_driver_firmware ⇒ mpu_load_firmware ⇒ mpu_write_mem ⇒ i2c_write

[Calls]

- >> mpu_load_firmware

[Called By]

- >> setup_MPU_6050

dmp_read_fifo (Thumb, 460 bytes, Stack size 88 bytes, inv_mpu_dmp_motion_driver.o(i.dmp_read_fifo))

[Stack]

- Max Depth = 160
- Call Chain = dmp_read_fifo ⇒ mpu_read_fifo_stream ⇒ mpu_reset_fifo ⇒ i2c_write

[Calls]

- >> decode_gesture
- >> get_ms
- >> mpu_reset_fifo
- >> mpu_read_fifo_stream

[Called By]

- >> main

dmp_set_fifo_rate (Thumb, 94 bytes, Stack size 32 bytes, inv_mpu_dmp_motion_driver.o(i.dmp_set_fifo_rate))

[Stack]

- Max Depth = 96
- Call Chain = dmp_set_fifo_rate ⇒ mpu_write_mem ⇒ i2c_write

[Calls]

- >> mpu_write_mem
- >> __aeabi_idivmod

[Called By]

- >> setup_MPU_6050

dmp_set_interrupt_mode (Thumb, 62 bytes, Stack size 32 bytes, inv_mpu_dmp_motion_driver.o(i.dmp_set_interrupt_mode))

[Stack]

- Max Depth = 96
- Call Chain = dmp_set_interrupt_mode ⇒ mpu_write_mem ⇒ i2c_write

[Calls]

- >> mpu_write_mem

[Called By]

- >> setup_MPU_6050

dmp_set_shake_reject_thresh (Thumb, 58 bytes, Stack size 24 bytes, inv_mpu_dmp_motion_driver.o(i.dmp_set_shake_reject_thresh))

[Stack]

- Max Depth = 88
- Call Chain = dmp_set_shake_reject_thresh ⇒ mpu_write_mem ⇒ i2c_write

[Calls]

- >> mpu_write_mem
- >> __aeabi_idivmod

[Called By]

- >> dmp_enable_feature

dmp_set_shake_reject_time (Thumb, 36 bytes, Stack size 16 bytes, inv_mpu_dmp_motion_driver.o(i.dmp_set_shake_reject_time))

[Stack]

- Max Depth = 80
- Call Chain = dmp_set_shake_reject_time ⇒ mpu_write_mem ⇒ i2c_write

[Calls]

- >> mpu_write_mem
- >> __aeabi_idivmod

[Called By]

- >> dmp_enable_feature

dmp_set_shake_reject_timeout (Thumb, 36 bytes, Stack size 16 bytes, inv_mpu_dmp_motion_driver.o(i.dmp_set_shake_reject_timeout))

[Stack]

- Max Depth = 80
- Call Chain = dmp_set_shake_reject_timeout ⇒ mpu_write_mem ⇒ i2c_write

[Calls]

- >> mpu_write_mem
- >> __aeabi_idivmod

[Called By]

- >> dmp_enable_feature

dmp_set_tap_axes (Thumb, 76 bytes, Stack size 16 bytes, inv_mpu_dmp_motion_driver.o(i.dmp_set_tap_axes))

[Stack]

- Max Depth = 80
- Call Chain = dmp_set_tap_axes ⇒ mpu_write_mem ⇒ i2c_write

[Calls]

- >> mpu_write_mem

[Called By]

- >> dmp_enable_feature

dmp_set_tap_count (Thumb, 38 bytes, Stack size 16 bytes, inv_mpu_dmp_motion_driver.o(i.dmp_set_tap_count))

[Stack]

- Max Depth = 80
- Call Chain = dmp_set_tap_count ⇒ mpu_write_mem ⇒ i2c_write

[Calls]

- >> mpu_write_mem

[Called By]

- >> dmp_enable_feature

dmp_set_tap_thresh (Thumb, 408 bytes, Stack size 40 bytes, inv_mpu_dmp_motion_driver.o(i.dmp_set_tap_thresh))

[Stack]

- Max Depth = 104
- Call Chain = dmp_set_tap_thresh ⇒ mpu_write_mem ⇒ i2c_write

[Calls]

- >> mpu_write_mem
- >> mpu_get_accel_fsr
- >> __aeabi_fmul
- >> __aeabi_ui2f
- >> __aeabi_f2uiz
- >> __aeabi_fdiv

[Called By]

- >> dmp_enable_feature

dmp_set_tap_time (Thumb, 36 bytes, Stack size 16 bytes, inv_mpu_dmp_motion_driver.o(i.dmp_set_tap_time))

[Stack]

- Max Depth = 80
- Call Chain = dmp_set_tap_time ⇒ mpu_write_mem ⇒ i2c_write

[Calls]

- >> mpu_write_mem
- >> __aeabi_idivmod

[Called By]

- >> dmp_enable_feature

dmp_set_tap_time_multi (Thumb, 36 bytes, Stack size 16 bytes, inv_mpu_dmp_motion_driver.o(i.dmp_set_tap_time_multi))

[Stack]

- Max Depth = 80
- Call Chain = dmp_set_tap_time_multi ⇒ mpu_write_mem ⇒ i2c_write

[Calls]

- >> mpu_write_mem
- >> __aeabi_idivmod

[Called By]

- >> dmp_enable_feature

enable_timer32 (Thumb, 24 bytes, Stack size 0 bytes, timer32.o(i.enable_timer32))

[Called By]

- >> main

ferror (Thumb, 8 bytes, Stack size 0 bytes, retarget.o(i.ferror))

[Called By]

- >> _printf_char_file

fputc (Thumb, 14 bytes, Stack size 16 bytes, retarget.o(i.fputc))

[Stack]

- Max Depth = 16
- Call Chain = fputc

[Calls]

- >> sendchar

[Address Reference Count : 1]

- _printf_char_file.o(.text)

get_ms (Thumb, 14 bytes, Stack size 8 bytes, m0_mpu_6050.o(i.get_ms))

[Stack]

- Max Depth = 8
- Call Chain = get_ms

[Calls]

- >> read_timer32

[Called By]

- >> dmp_read_fifo

i2c_clear_buffers (Thumb, 24 bytes, Stack size 0 bytes, m0_mpu_6050.o(i.i2c_clear_buffers))

[Called By]

- >> i2c_write
- >> i2c_read

i2c_read (Thumb, 86 bytes, Stack size 40 bytes, m0_mpu_6050.o(i.i2c_read))

[Stack]

- Max Depth = 40
- Call Chain = i2c_read

[Calls]

- >> i2c_clear_buffers
- >> I2CEngine

[Called By]

- >> mpu_set_bypass
- >> mpu_read_mem
- >> mpu_read_fifo_stream

i2c_write (Thumb, 84 bytes, Stack size 40 bytes, m0_mpu_6050.o(i.i2c_write))

[Stack]

- Max Depth = 40
- Call Chain = i2c_write

[Calls]

- >> i2c_clear_buffers
- >> I2CEngine

[Called By]

- >> mpu_write_mem
- >> mpu_set_lpf
- >> mpu_set_int_latched
- >> mpu_set_gyro_fsr
- >> mpu_set_bypass
- >> mpu_set_accel_fsr
- >> mpu_reset_fifo
- >> mpu_read_mem
- >> mpu_lp_accel_mode
- >> mpu_load_firmware
- >> set_int_enable
- >> mpu_set_sensors
- >> mpu_set_sample_rate
- >> mpu_set_dmp_state
- >> mpu_init

init_timer32 (Thumb, 64 bytes, Stack size 8 bytes, timer32.o(i.init_timer32))

[Stack]

- Max Depth = 8
- Call Chain = init_timer32

[Calls]

- >> reset_timer32

[Called By]

- >> delay32Ms
- >> main

main (Thumb, 140 bytes, Stack size 16 bytes, main.o(i.main))

[Stack]

- Max Depth = 192 + Unknown Stack Size
- Call Chain = main ⇒ setup_MPU_6050 ⇒ mpu_init ⇒ reg_int_cb ⇒ __2printf ⇒ _printf_char_file ⇒ _printf_char_common ⇒ __printf

[Calls]

- >> init_timer32
- >> enable_timer32
- >> dmp_read_fifo
- >> delay32Ms
- >> SER_init
- >> I2CInit
- >> setup_MPU_6050
- >> __aeabi_uidivmod
- >> __2printf

[Called By]

- >> __rt_entry_main

mpu_configure_fifo (Thumb, 124 bytes, Stack size 16 bytes, inv_mpu.o(i.mpu_configure_fifo))

[Stack]

- Max Depth = 72
- Call Chain = mpu_configure_fifo ⇒ set_int_enable ⇒ i2c_write

[Calls]

- >> mpu_reset_fifo
- >> set_int_enable

[Called By]

- >> mpu_lp_accel_mode
- >> mpu_init
- >> setup_MPU_6050

mpu_get_accel_fsr (Thumb, 76 bytes, Stack size 0 bytes, inv_mpu.o(i.mpu_get_accel_fsr))

[Called By]

- >> dmp_set_tap_thresh
- >> setup_MPU_6050

mpu_get_accel_sens (Thumb, 82 bytes, Stack size 0 bytes, inv_mpu.o(i.mpu_get_accel_sens))

[Called By]

- >> setup_MPU_6050

mpu_get_gyro_fsr (Thumb, 66 bytes, Stack size 0 bytes, inv_mpu.o(i.mpu_get_gyro_fsr))

[Called By]

- >> setup_MPU_6050

mpu_get_gyro_sens (Thumb, 60 bytes, Stack size 0 bytes, inv_mpu.o(i.mpu_get_gyro_sens))

[Called By]

- >> setup_MPU_6050

mpu_get_sample_rate (Thumb, 28 bytes, Stack size 0 bytes, inv_mpu.o(i.mpu_get_sample_rate))

[Called By]

- >> setup_MPU_6050

mpu_init (Thumb, 276 bytes, Stack size 16 bytes, inv_mpu.o(i.mpu_init))

[Stack]

- Max Depth = 160 + Unknown Stack Size
- Call Chain = mpu_init ⇒ reg_int_cb ⇒ __2printf ⇒ _printf_char_file ⇒ _printf_char_common ⇒ __printf

[Calls]

- >> reg_int_cb
- >> i2c_write
- >> delay_ms
- >> mpu_set_lpf
- >> mpu_set_gyro_fsr
- >> mpu_set_bypass
- >> mpu_set_accel_fsr
- >> mpu_set_sensors
- >> mpu_set_sample_rate
- >> mpu_configure_fifo
- >> __aeabi_memclr

[Called By]

- >> setup_MPU_6050

mpu_load_firmware (Thumb, 188 bytes, Stack size 64 bytes, inv_mpu.o(i.mpu_load_firmware))

[Stack]

- Max Depth = 128
- Call Chain = mpu_load_firmware ⇒ mpu_write_mem ⇒ i2c_write

[Calls]

- >> i2c_write
- >> mpu_write_mem
- >> mpu_read_mem
- >> memcmp

[Called By]

- >> dmp_load_motion_driver_firmware

mpu_lp_accel_mode (Thumb, 216 bytes, Stack size 16 bytes, inv_mpu.o(i.mpu_lp_accel_mode))

[Stack]

- Max Depth = 88
- Call Chain = mpu_lp_accel_mode ⇒ mpu_configure_fifo ⇒ set_int_enable ⇒ i2c_write

[Calls]

- >> i2c_write
- >> mpu_set_lpf
- >> mpu_set_int_latched
- >> mpu_configure_fifo

[Called By]

- >> mpu_set_sample_rate

mpu_read_fifo_stream (Thumb, 210 bytes, Stack size 24 bytes, inv_mpu.o(i.mpu_read_fifo_stream))

[Stack]

- Max Depth = 72
- Call Chain = mpu_read_fifo_stream ⇒ mpu_reset_fifo ⇒ i2c_write

[Calls]

- >> i2c_read
- >> mpu_reset_fifo
- >> __aeabi_idivmod

[Called By]

- >> dmp_read_fifo

mpu_read_mem (Thumb, 120 bytes, Stack size 24 bytes, inv_mpu.o(i.mpu_read_mem))

[Stack]

- Max Depth = 64
- Call Chain = mpu_read_mem ⇒ i2c_write

[Calls]

- >> i2c_write
- >> i2c_read

[Called By]

- >> mpu_load_firmware

mpu_reset_fifo (Thumb, 480 bytes, Stack size 8 bytes, inv_mpu.o(i.mpu_reset_fifo))

[Stack]

- Max Depth = 48
- Call Chain = mpu_reset_fifo ⇒ i2c_write

[Calls]

- >> i2c_write
- >> delay_ms

[Called By]

- >> dmp_enable_lp_quat
- >> dmp_enable_6x_lp_quat
- >> mpu_read_fifo_stream
- >> mpu_set_dmp_state
- >> mpu_configure_fifo
- >> dmp_read_fifo
- >> dmp_enable_feature

mpu_set_accel_fsr (Thumb, 128 bytes, Stack size 16 bytes, inv_mpu.o(i.mpu_set_accel_fsr))

[Stack]

- Max Depth = 56
- Call Chain = mpu_set_accel_fsr ⇒ i2c_write

[Calls]

- >> i2c_write

[Called By]

- >> mpu_init

mpu_set_bypass (Thumb, 348 bytes, Stack size 16 bytes, inv_mpu.o(i.mpu_set_bypass))

[Stack]

- Max Depth = 56
- Call Chain = mpu_set_bypass ⇒ i2c_write

[Calls]

- >> i2c_write
- >> i2c_read
- >> delay_ms

[Called By]

- >> mpu_set_dmp_state
- >> mpu_init

mpu_set_dmp_state (Thumb, 140 bytes, Stack size 16 bytes, inv_mpu.o(i.mpu_set_dmp_state))

[Stack]

- Max Depth = 120
- Call Chain = mpu_set_dmp_state ⇒ mpu_set_sample_rate ⇒ mpu_lp_accel_mode ⇒ mpu_configure_fifo ⇒ set_int_enable ⇒ i2c_write

[Calls]

- >> i2c_write
- >> mpu_set_bypass
- >> mpu_reset_fifo
- >> set_int_enable
- >> mpu_set_sample_rate

[Called By]

- >> setup_MPU_6050

mpu_set_gyro_fsr (Thumb, 142 bytes, Stack size 16 bytes, inv_mpu.o(i.mpu_set_gyro_fsr))

[Stack]

- Max Depth = 56
- Call Chain = mpu_set_gyro_fsr ⇒ i2c_write

[Calls]

- >> i2c_write

[Called By]

- >> mpu_init

mpu_set_int_latched (Thumb, 110 bytes, Stack size 16 bytes, inv_mpu.o(i.mpu_set_int_latched))

[Stack]

- Max Depth = 56
- Call Chain = mpu_set_int_latched ⇒ i2c_write

[Calls]

- >> i2c_write

[Called By]

- >> mpu_lp_accel_mode
- >> mpu_set_sensors

mpu_set_lpf (Thumb, 128 bytes, Stack size 16 bytes, inv_mpu.o(i.mpu_set_lpf))

[Stack]

- Max Depth = 56
- Call Chain = mpu_set_lpf ⇒ i2c_write

[Calls]

- >> i2c_write

[Called By]

- >> mpu_lp_accel_mode
- >> mpu_set_sample_rate
- >> mpu_init

mpu_set_sample_rate (Thumb, 162 bytes, Stack size 16 bytes, inv_mpu.o(i.mpu_set_sample_rate))

[Stack]

- Max Depth = 104
- Call Chain = mpu_set_sample_rate ⇒ mpu_lp_accel_mode ⇒ mpu_configure_fifo ⇒ set_int_enable ⇒ i2c_write

[Calls]

- >> i2c_write
- >> mpu_set_lpf
- >> mpu_lp_accel_mode
- >> __aeabi_idivmod

[Called By]

- >> mpu_set_dmp_state
- >> mpu_init
- >> setup_MPU_6050

mpu_set_sensors (Thumb, 220 bytes, Stack size 16 bytes, inv_mpu.o(i.mpu_set_sensors))

[Stack]

- Max Depth = 72
- Call Chain = mpu_set_sensors ⇒ mpu_set_int_latched ⇒ i2c_write

[Calls]

- >> i2c_write
- >> delay_ms
- >> mpu_set_int_latched

[Called By]

- >> mpu_init
- >> setup_MPU_6050

mpu_write_mem (Thumb, 120 bytes, Stack size 24 bytes, inv_mpu.o(i.mpu_write_mem))

[Stack]

- Max Depth = 64
- Call Chain = mpu_write_mem ⇒ i2c_write

[Calls]

- >> i2c_write

[Called By]

- >> dmp_set_tap_time_multi
- >> dmp_set_tap_time
- >> dmp_set_tap_thresh
- >> dmp_set_tap_count
- >> dmp_set_tap_axes
- >> dmp_set_shake_reject_timeout
- >> dmp_set_shake_reject_time
- >> dmp_set_shake_reject_thresh
- >> dmp_enable_lp_quat
- >> dmp_enable_gyro_cal
- >> dmp_enable_6x_lp_quat
- >> mpu_load_firmware
- >> dmp_set_interrupt_mode
- >> dmp_set_fifo_rate
- >> dmp_enable_feature

read_timer32 (Thumb, 22 bytes, Stack size 0 bytes, timer32.o(i.read_timer32))

[Called By]

- >> get_ms

reg_int_cb (Thumb, 102 bytes, Stack size 8 bytes, m0_mpu_6050.o(i.reg_int_cb))

[Stack]

- Max Depth = 144 + Unknown Stack Size
- Call Chain = reg_int_cb ⇒ __2printf ⇒ _printf_char_file ⇒ _printf_char_common ⇒ __printf

[Calls]

- >> __2printf

[Called By]

- >> mpu_init

reset_timer32 (Thumb, 38 bytes, Stack size 0 bytes, timer32.o(i.reset_timer32))

[Called By]

- >> init_timer32
- >> delay32Ms

sendchar (Thumb, 20 bytes, Stack size 0 bytes, serial.o(i.sendchar))

[Called By]

- >> fputc

setup_MPU_6050 (Thumb, 196 bytes, Stack size 16 bytes, main.o(i.setup_MPU_6050))

[Stack]

- Max Depth = 176 + Unknown Stack Size
- Call Chain = setup_MPU_6050 ⇒ mpu_init ⇒ reg_int_cb ⇒ __2printf ⇒ _printf_char_file ⇒ _printf_char_common ⇒ __printf

[Calls]

- >> mpu_set_sensors
- >> mpu_set_sample_rate
- >> mpu_set_dmp_state
- >> mpu_init
- >> mpu_get_sample_rate
- >> mpu_get_gyro_sens
- >> mpu_get_gyro_fsr
- >> mpu_get_accel_sens
- >> mpu_get_accel_fsr
- >> mpu_configure_fifo
- >> dmp_set_interrupt_mode
- >> dmp_set_fifo_rate
- >> dmp_load_motion_driver_firmware
- >> dmp_enable_feature
- >> __2printf

[Called By]

- >> main

__aeabi_fmul (Thumb, 0 bytes, Stack size 16 bytes, fmul.o(x$fpl$fmul))

[Stack]

- Max Depth = 16
- Call Chain = __aeabi_fmul

[Called By]

- >> dmp_set_tap_thresh

_fmul (Thumb, 172 bytes, Stack size 16 bytes, fmul.o(x$fpl$fmul), UNUSED)

### Local Symbols

set_int_enable (Thumb, 166 bytes, Stack size 16 bytes, inv_mpu.o(i.set_int_enable))

[Stack]

- Max Depth = 56
- Call Chain = set_int_enable ⇒ i2c_write

[Calls]

- >> i2c_write

[Called By]

- >> mpu_set_dmp_state
- >> mpu_configure_fifo

decode_gesture (Thumb, 100 bytes, Stack size 24 bytes, inv_mpu_dmp_motion_driver.o(i.decode_gesture))

[Stack]

- Max Depth = 24
- Call Chain = decode_gesture

[Called By]

- >> dmp_read_fifo

_printf_input_char (Thumb, 10 bytes, Stack size 0 bytes, _printf_char_common.o(.text))
[Address Reference Count : 1]

- _printf_char_common.o(.text)

### Undefined Global Symbols

_call_atexit_fns (ARM, 0 bytes, Stack size 0 bytes, UNDEFINED)

[Called By]

- >> exit

_printf_truncate_signed (ARM, 0 bytes, Stack size 0 bytes, UNDEFINED)

[Called By]

- >> _printf_int_dec

_printf_truncate_unsigned (ARM, 0 bytes, Stack size 0 bytes, UNDEFINED)

[Called By]

- >> _printf_int_dec
