rauhul/ece395/(commit log)

2017-02-01 initial PID loop
2017-02-09 Upload flywheel gearbox design
    [0.500 10-32.SLDPRT, 12t_gear.SLDPRT, 18t_gear.SLDPRT, 60t_gear.SLDPRT, FR8-2RZ.SLDPRT, cim_motor.SLDPRT, flywheel.SLDPRT, flywheel_plate.SLDPRT]
2017-02-27 remove old files and restructure repo
    [HAL_FLASH.obj, HAL_PMAP.obj, HAL_PMM.obj, HAL_TLV.obj, HAL_UCS.obj, UsbCdc.obj, UsbHid.obj, UsbHidReq.obj]
2017-02-28 create dir for gyro reading ARM code and generic ignore
2017-02-28 I2C lib done?
2017-03-07 Update fly_wheel gearbox
    [0.500 10-32.SLDPRT, 12t_gear.SLDPRT, 18t_gear.SLDPRT, 60t_gear.SLDPRT, FR8-2RZ.SLDPRT, flywheel.SLDDRW, flywheel.SLDPRT, flywheel_plate.SLDDRW]
2017-04-03 Get the MPU 6050 dmp working with an Arduino Uno
    Incomplete, unable to correctly initialize the dmp due to SRAM limitations on the Uno
    [Arduino_MPU_6050.cpp, Arduino_MPU_6050.h, inv_mpu.c, inv_mpu.h, inv_mpu_dmp_motion_driver.c, inv_mpu_dmp_motion_driver.h, test_dmp_arduino.ino]
2017-04-03 Initial MPU 6050 support for the cortex m0
    linker issue in m0_mpu_6050
    [driver_config.h, i2c.c, i2c.h, inv_mpu.c, inv_mpu.h, inv_mpu_dmp_motion_driver.c, inv_mpu_dmp_motion_driver.h, m0_mpu_6050.c]
2017-04-04 fixed bugs in i2c read/write
    [i2c.c, inv_mpu.c, m0_mpu_6050.c, m0_mpu_6050.h, main.c]
2017-04-17 fix MPU6050 LPC1114 I2C Driver, setup interrupt
    [Arduino_MPU_6050.cpp, inv_mpu.c, inv_mpu.h, m0_mpu_6050.c, m0_mpu_6050.h, main.c, test_dmp_arduino.ino]
